bridge42worlds/wheel2/docs/spec.md

# Спецификация и смета

Из чего собрана установка и сколько это стоит. Цены — в кувейтских динарах (KWD; 1 KWD ≈ 3,25 $):

* **без знака** — как оплачено в заказах AliExpress, доставка в основном бесплатная;
* **≈** — оценка по поиску AliExpress (26.10.2026): этого нет в заказах — надо купить или куплено отдельно;
* **—** — куплено на месте или своё, без цены.

Ссылки ведут на страницы товаров; цены и варианты на них меняются. Где что стоит в установке — [схемы подключения](wiring.md).

## Итог

| раздел | куплено, KWD | оценка, KWD | всего, KWD |
|---|---|---|---|
| Агенты и датчики | 96,88 | — | 96,88 |
| Колёса и катушки | 29,64 | ≈ 32,01 | 61,65 |
| Питание колёс | 29,62 | ≈ 32,26 | 61,88 |
| Рама и моторы | 34,08 | ≈ 3,09 | 37,17 |
| Сеть опыта (Wi-Fi) | 13,81 | — | 13,81 |
| Монтаж и тепло | 4,95 | — | 4,95 |
| Инструменты и расходники | 32,92 | — | 32,92 |
| **установка без инструментов** | **208,98** | **≈ 67,36** | **276,34** (≈ 898 $) |
| **всё вместе с инструментами** | **241,90** | **≈ 67,36** | **309,26** (≈ 1 005 $) |

Ноутбук (сервер) и телефон Samsung Galaxy A26 (статический датчик №9) — свои, в смету не входят.

Купить осталось: аккумуляторы 18650 и боксы к ним, недостающие радиаторы, DRV8833 — запасные мосты катушек. Медный провод и часть радиаторов куплены отдельно, их цена неизвестна — в оценке ориентир AliExpress.

## Агенты и датчики

Платы-агенты и датчики: генераторы и поглотители на колёсах, агенты катушек и моторов, статика.

| позиция | вариант, сколько | цена | шт. | сумма | ссылка | примечание |
|---|---|---|---|---|---|---|
| Seeed XIAO ESP32-S3 — агент | упаковка 10 шт. | 22,19 и 23,58 | 2 | 45,77 | [AliExpress](https://www.aliexpress.com/item/1005006987905528.html) | 20 плат: 12 на колёсах, катушка, моторы, статика, запас |
| Акселерометр-гироскоп ICM-42688 (фиолетовая плата) | датчик обода, статика | 5,69 | 2 | 11,38 | [AliExpress](https://www.aliexpress.com/item/1005011642881650.html) |  |
| Магнитометр MLX90393 | упаковка 2 шт. | 4,98 | 1 | 4,98 | [AliExpress](https://www.aliexpress.com/item/1005012414990689.html) | поле в трубе колеса |
| Точный акселерометр ADXL355 | статика по центру оси | 23,82 | 1 | 23,82 | [AliExpress](https://www.aliexpress.com/item/1005009311859684.html) | шум 25 мкg/√Гц |
| Измеритель тока INA219 | упаковка 5 шт. | 1,79 | 1 | 1,79 | [AliExpress](https://www.aliexpress.com/item/1005004939456588.html) | заряд аккумуляторов: по одному на шину и катушку колеса |
| Seeed XIAO ESP32-C3 | упаковка 10 шт. | 4,57 | 2 | 9,14 | [AliExpress](https://www.aliexpress.com/item/1005008791937363.html) | в установке не используются — запас |

Раздел: куплено **96,88 KWD**.

## Колёса и катушки

Обод — силиконовая труба на алюминиевом диске, на трубу намотана катушка; мост катушки, радиаторы агентов.

| позиция | вариант, сколько | цена | шт. | сумма | ссылка | примечание |
|---|---|---|---|---|---|---|
| Алюминиевый диск 6061 Ø300 × 3 мм | основа колеса | 10,38 | 2 | 20,76 | [AliExpress](https://www.aliexpress.com/item/1005008038945720.html) |  |
| Силиконовая трубка пищевая, ID 19 × OD 23 мм | обод — агенты внутри | 6,56 | 1 | 6,56 | [AliExpress](https://www.aliexpress.com/item/1005010025288570.html) |  |
| Клипсы ПВХ U-образные 25 мм | 20 шт. | 2,32 | 1 | 2,32 | [AliExpress](https://www.aliexpress.com/item/1005009762220367.html) | крепят трубу к диску |
| Эмалированный медный провод 0,67 мм | ~200 м на два колеса (≈0,6 кг) | ≈ 19,18 | 1 | ≈ 19,18 | [AliExpress](https://www.aliexpress.com/item/1005003650119052.html) | куплен отдельно; ориентир — катушка 1 кг |
| Мост DRV8833 — запасной для катушек | 2,7–10,8 В | ≈ 0,76 | 2 | ≈ 1,52 | [AliExpress](https://www.aliexpress.com/item/1005009044264044.html) | на катушках работают DRV8871 от 5,1 В (вне паспорта); эти — на случай отказа |
| Радиатор алюминиевый 10 × 10 × 10 мм | по 2 на агента: 24 шт. (3 упаковки по 10) | ≈ 3,77 | 3 | ≈ 11,31 | [AliExpress](https://www.aliexpress.com/item/1005004079109702.html) | часть уже стоит на агентах — уточнить, сколько есть |

Раздел: куплено **29,64 KWD**, докупить или оценка **≈ 32,01 KWD**.

## Питание колёс

По два блока 2×18650 на колесо (шина агентов и катушка), DC-DC 5,1 В, защита и проводка.

| позиция | вариант, сколько | цена | шт. | сумма | ссылка | примечание |
|---|---|---|---|---|---|---|
| Аккумулятор 18650, 3400 мА·ч (LiitoKala NCR18650B) | 8 в работе + 2 запасных | ≈ 2,71 | 10 | ≈ 27,10 | [AliExpress](https://www.aliexpress.com/item/1005010576713983.html) | купить; нынешние банки слабые — около 0,7 А·ч на пару ([замер](coil_test.md)); литиевые аккумуляторы в Кувейт везут не все продавцы — проверить доставку |
| Бокс 2×18650 с крышкой и выключателем | по 2 на колесо | ≈ 1,29 | 4 | ≈ 5,16 | [AliExpress](https://www.aliexpress.com/item/4001207701699.html) | купить |
| Зарядное устройство LiitoKala Lii-402 | на 4 аккумулятора | 3,96 | 1 | 3,96 | [AliExpress](https://www.aliexpress.com/item/1005008078706966.html) |  |
| DC-DC LM2596 с вольтметром | 3 шт. | 1,40 | 3 | 4,20 | [AliExpress](https://www.aliexpress.com/item/1005010587294093.html) | 5 в работе: шина и катушка каждого колеса, агент моторов |
| DC-DC LM2596 с индикатором | 2 шт. | 1,24 | 2 | 2,48 | [AliExpress](https://www.aliexpress.com/item/1005006735114768.html) |  |
| Диоды Шоттки 1N5819 | 50 шт. | 0,86 | 1 | 0,86 | [AliExpress](https://www.aliexpress.com/item/1005001552094086.html) | полоской к 5V агента |
| Диоды 1N4007 | 50 шт. | 0,76 | 1 | 0,76 | [AliExpress](https://www.aliexpress.com/item/1005001552094086.html) | запас |
| Электролиты 470 мкФ 25 В | 20 шт. | 0,85 | 1 | 0,85 | [AliExpress](https://www.aliexpress.com/item/1005005945721276.html) | C1–C3 на шине, у мостов |
| Электролиты, набор | 120 шт. | 1,02 | 1 | 1,02 | [AliExpress](https://www.aliexpress.com/item/1005006244064108.html) |  |
| Керамика 104 (0,1 мкФ) 50 В | 100 шт. | 0,68 | 1 | 0,68 | [AliExpress](https://www.aliexpress.com/item/1005008165798085.html) | на выводах моторов |
| Керамика, набор | 300 шт. | 1,15 | 1 | 1,15 | [AliExpress](https://www.aliexpress.com/item/1005008244407175.html) |  |
| Держатель предохранителя 18AWG с предохранителем 3 А | 2 шт. | 0,73 | 2 | 1,46 | [AliExpress](https://www.aliexpress.com/item/1005007369776673.html) |  |
| Провод 2 × 18 AWG (красный-чёрный) | 10 м | 3,22 | 1 | 3,22 | [AliExpress](https://www.aliexpress.com/item/1005009014635843.html) | шины |
| Провод силиконовый 20 AWG | 3 м | 0,70 | 1 | 0,70 | [AliExpress](https://www.aliexpress.com/item/1005009017260144.html) |  |
| Провод силиконовый 22 AWG | 3 м | 0,64 | 1 | 0,64 | [AliExpress](https://www.aliexpress.com/item/1005009017260144.html) |  |
| Т-соединители проводов | 20 шт. | 2,24 | 1 | 2,24 | [AliExpress](https://www.aliexpress.com/item/1005011893119817.html) | отводы от шины к агентам |
| Разъёмы H2, 2 контакта | 50 шт. | 1,53 | 1 | 1,53 | [AliExpress](https://www.aliexpress.com/item/1005008802959407.html) |  |
| Клеммники компактные | 5 шт. | 0,57 | 4 | 2,28 | [AliExpress](https://www.aliexpress.com/item/1005012488325489.html) |  |
| Термоусадка, набор | 127 шт. | 0,89 | 1 | 0,89 | [AliExpress](https://www.aliexpress.com/item/1005010440409440.html) |  |
| Вольтметр-амперметр DC 100 В 10 А | 1 шт. | 0,70 | 1 | 0,70 | [AliExpress](https://www.aliexpress.com/item/1005005631605113.html) |  |

Раздел: куплено **29,62 KWD**, докупить или оценка **≈ 32,26 KWD**.

## Рама и моторы

Моторы на осях колёс, мосты, агент моторов на раме; блок 12 В.

| позиция | вариант, сколько | цена | шт. | сумма | ссылка | примечание |
|---|---|---|---|---|---|---|
| Мотор-редуктор 36GP-555, 12 В, 112 об/мин | по одному на колесо | 14,23 | 2 | 28,46 | [AliExpress](https://www.aliexpress.com/item/1005012582421407.html) |  |
| Мост DRV8871 | упаковка 5 шт. | 3,86 | 1 | 3,86 | [AliExpress](https://www.aliexpress.com/item/1005012157077217.html) | моторы — 2, катушка колеса 1 — 1 (от 5,1 В работает) |
| Опора вала с фланцем, 8 мм | 2 шт. | 0,88 | 2 | 1,76 | [AliExpress](https://www.aliexpress.com/item/1005011593372874.html) |  |
| Блок питания 12 В 5 А (60 Вт) | моторы и агент моторов | ≈ 3,09 | 1 | ≈ 3,09 | [AliExpress](https://www.aliexpress.com/item/1005004110696893.html) | в заказах AliExpress нет — уточнить, какой стоит |
| Фанера 12 мм, подшипники упоров, муфты, крепёж | рама и упоры | — | 1 | — | — | куплено на месте |

Раздел: куплено **34,08 KWD**, докупить или оценка **≈ 3,09 KWD**.

## Сеть опыта (Wi-Fi)

Свой роутер только для агентов; ноутбук — к нему кабелем, интернет — по своему Wi-Fi.

| позиция | вариант, сколько | цена | шт. | сумма | ссылка | примечание |
|---|---|---|---|---|---|---|
| Роутер GL.iNet GL-MT300N-V2 (Mango) | 2,4 ГГц, питание micro-USB 5 В | 8,60 | 1 | 8,60 | [AliExpress](https://www.aliexpress.com/item/1005005454366776.html) | настройки — [схемы, «Сеть опыта»](wiring.md#сеть-опыта-wi-fi) |
| Адаптер UGREEN USB 3.0 → RJ45 (ASIX AX88179) | ноутбук ↔ LAN роутера | 3,30 | 1 | 3,30 | [AliExpress](https://www.aliexpress.com/item/1005007088906526.html) |  |
| Кабель Cat6 | 3 м | 1,91 | 1 | 1,91 | [AliExpress](https://www.aliexpress.com/item/1005009029087811.html) |  |
| Второй роутер (домашний) | запасная сеть агентов | — | 1 | — | — | свой |

Раздел: куплено **13,81 KWD**.

## Монтаж и тепло

Крепление радиаторов и плат, изоляция под обмоткой.

| позиция | вариант, сколько | цена | шт. | сумма | ссылка | примечание |
|---|---|---|---|---|---|---|
| Двусторонний термоскотч 10 мм | 5 м | 0,92 | 1 | 0,92 | [AliExpress](https://www.aliexpress.com/item/1005005721222386.html) | радиаторы на плату |
| Каптоновая лента 20 мм | 33 м | 1,65 | 1 | 1,65 | [AliExpress](https://www.aliexpress.com/item/1005002708125522.html) | кромки радиаторов под проводом |
| Клей AB для металла | 50 мл | 2,00 | 1 | 2,00 | [AliExpress](https://www.aliexpress.com/item/1005008690859660.html) |  |
| Нано-лента двусторонняя 20 мм | 1 м | 0,38 | 1 | 0,38 | [AliExpress](https://www.aliexpress.com/item/1005010778627319.html) |  |

Раздел: куплено **4,95 KWD**.

## Инструменты и расходники

Для сборки — в стоимость самой установки не входят.

| позиция | вариант, сколько | цена | шт. | сумма | ссылка | примечание |
|---|---|---|---|---|---|---|
| Паяльник 60 Вт с регулятором (S806), набор 7 в 1 |  | 2,49 | 1 | 2,49 | [AliExpress](https://www.aliexpress.com/item/1005007111909400.html) |  |
| «Третья рука» с лупой, 4 держателя |  | 2,17 | 1 | 2,17 | [AliExpress](https://www.aliexpress.com/item/1005009212103647.html) |  |
| Силиконовый коврик для пайки |  | 1,27 | 1 | 1,27 | [AliExpress](https://www.aliexpress.com/item/1005005241808257.html) |  |
| Лупа-очки |  | 6,00 | 1 | 6,00 | [AliExpress](https://www.aliexpress.com/item/1005005669666176.html) |  |
| Отвёртка 7 в 1 |  | 1,21 | 1 | 1,21 | [AliExpress](https://www.aliexpress.com/item/1005012615752371.html) |  |
| Стриппер-обжимник 10–26 AWG |  | 2,61 | 1 | 2,61 | [AliExpress](https://www.aliexpress.com/item/1005009138448458.html) |  |
| Набор ножей |  | 0,70 | 1 | 0,70 | [AliExpress](https://www.aliexpress.com/item/1005005733410013.html) |  |
| Струбцины 4" | 5 шт. | 5,10 | 1 | 5,10 | [AliExpress](https://www.aliexpress.com/item/1005007147995927.html) |  |
| Пружинные зажимы 3" | 6 шт. | 1,66 | 2 | 3,32 | [AliExpress](https://www.aliexpress.com/item/1005006441096614.html) |  |
| Струбцины 2" | 10 шт. | 1,46 | 1 | 1,46 | [AliExpress](https://www.aliexpress.com/item/1005008565541292.html) |  |
| Припой ПОС-63 с канифолью, 0,8 мм | 50 г | 1,37 | 1 | 1,37 | [AliExpress](https://www.aliexpress.com/item/1005009113499721.html) |  |
| Флюс-карандаш 951 |  | 1,53 | 1 | 1,53 | [AliExpress](https://www.aliexpress.com/item/1005009476418222.html) |  |
| Оплётка для снятия припоя 2,5 мм | 1,5 м | 0,68 | 1 | 0,68 | [AliExpress](https://www.aliexpress.com/item/1005012817073895.html) |  |
| Паяльная паста | 15 г | 1,03 | 1 | 1,03 | [AliExpress](https://www.aliexpress.com/item/1005009377104599.html) |  |
| Ёмкость из нержавейки | 300 мл | 1,34 | 1 | 1,34 | [AliExpress](https://www.aliexpress.com/item/1005010588950996.html) |  |
| Подставка Type-C |  | 0,64 | 1 | 0,64 | [AliExpress](https://www.aliexpress.com/item/1005012357688054.html) |  |

Раздел: куплено **32,92 KWD**.
