bridge42worlds/wheel2/docs/check_2026-11-03.md

# Первая полная проверка установки

Журнал 03.11.2026, вечер. Всё включено: оба колеса (по шесть агентов на шине и агент катушки), статический
акселерометр №8, колесо‑пустышка №22 и №23, телефон №9, агент моторов №10. Колёса крутили только медленно
(ШИМ 30 %, ~25 об/мин), до невесомости (73 об/мин) не разгоняли — механику ещё смотрят.

## Прошивка

Все 19 плат прошиты по Wi‑Fi сборкой **6da4bb9** (коммит того же дня), каждая подтвердила новую версию.

| кто | было | прошивка по Wi‑Fi |
|---|---|---|
| колесо 1: №3, №5, №6, №11, №12, №20, катушка №13 | fcee625 | 7 плат за 83 с |
| колесо 2: №14–№19, катушка №21 | 4b221d0, 46f9960 | 7 плат за 79 с |
| статика №8, пустышки №22, №23 | fcee625, be44124-dirty | 3 платы за 75 с |
| моторы №10 | fcee625 | 75 с |

Новое в 6da4bb9: своё рассеяние `ss` ([scatter.md](scatter.md)), переменное поле катушек и поле «с вращением»
([sensors.md](sensors.md)), метка верха колеса.

## Агенты и датчики

| что | итог |
|---|---|
| связь | ✓ все на связи; за 20 с потерь 0 (у №16 — один пакет из 20); прежние 6–9 % потерь — от общего включения |
| акселерометр обода №6 (колесо 1) | ✓ 200 Гц, ошибок 0, \|a\| 995–1001 мg, гироскоп стоит; шум 0,45–0,59 мg, во второй раз 2,4–4,3 мg — колесо трогали |
| акселерометр обода №14 (колесо 2) | ✓ 200 Гц, ошибок 0, \|a\| 994–996 мg, шум 0,55–1,2 мg |
| магнитометр №20 (колесо 1) | ✓ шум до 1,7 мкТл; фон 84, потом 67 мкТл (обычно 25–65) — железо рядом, не датчик |
| магнитометр №18 (колесо 2) | ✓ фон 25–31 мкТл, шум до 1,7 мкТл |
| статика №8 (ADXL355) | ✓ 504 Гц, без пропусков, шум 0,4–1,2 мg |
| телефон №9 | ✓ акселерометр 481 Гц без пропусков (шум 0,7–1,8 мg), магнитометр ~120 Гц, батарея 50 % |
| аккумуляторы катушек | ✓ колесо 1 — 8,11 В (85 %), колесо 2 — 7,94 В (76 %); агент катушки без поля берёт 90–94 мА |

## Катушки

**Постоянное поле** (выкл → «+» → выкл → «−», 4 раза): ✓ на обоих колёсах ток шёл 4 из 4, поле по магнитометру
колеса 1305–1328 мкТл (колесо 1) и 1327–1342 мкТл (колесо 2), знак совпал с командой, после выключения — фон.

**Переменное поле** (обе катушки по очереди):

| род | итог |
|---|---|
| ∿ 1 Гц | ✓ огибающая растёт за ~3 с; фаза агента к часам сервера сходится до ±2 тысячных периода; магнитометр видит размах \|B\| 1285–1355 мкТл |
| ∿ 5 Гц | ✓ частота меняется на ходу; фаза ±2–26 тысячных (до 9°) — задержка сети при 5 Гц уже заметна |
| ⊓ мягкий меандр 1 Гц | ✓ смена формы через ноль; ток до 0,89–0,98 А |
| выкл | ✓ ток катушки спадает до тока агента (~92 мА) |

## Счёт и своё рассеяние

* **«Каждый сам», 30 с, все 14 генераторов** (оба колеса и пустышки): ✓ 23–25 простых в секунду на плату, ошибок 0,
  настройку приняли все; нагрев за 30 с — 41–46 °C, пустышки без радиаторов — 58–61 °C.
* **Своё рассеяние `ss`** (№3 сам рассеивает, №5 рядом без него, 40 с): ✓ 989 простых → 990 кадров, пропусков 0,
  шум не ждали, задержка 0,61 мс; №5 услышал 98 % кадров; скорость №3 не упала (~25 простых/с, как у №5).

## Моторы и вращение

* ШИМ 30 %, каждое колесо туда‑обратно по 6 с: колесо 1 — 22–25 об/мин, колесо 2 — 25–27 об/мин; \|a\| обода
  0,87–1,12 g — как должно при таких оборотах (k ≈ 0,1).
* Метка верха: ✓ у №6 приходит, период 2601 мс = 23,1 об/мин.
* **Найдено и исправлено:** перестановка мостов (`swap`, «колесо 1 на мосту b», поставлена 30.10) стала неверной —
  «колесо 1» крутило колесо, на котором №14 и №18. В режимах «по оборотам» и «невесомость» сервер разгонял бы одно
  колесо, а смотрел бы обороты другого (стоящего) и поднимал бы ШИМ до ограничителя. Перестановка снята; проверено:
  мост a → колесо 1 (№6 до 24,9 об/мин), мост b → колесо 2 (№14 до 26,1 об/мин), другое колесо стоит.
* Колесо 2 в первом заходе вперёд почти не пошло (1,6 об/мин в последнюю секунду). Повторная проверка — 6 стартов
  из 6 чистые: трогается через 1,4–1,6 с вперёд и 1,8–2,0 с назад (с разгоном мотора), идёт 25–27 об/мин. Назад
  трогается на 0,3–0,4 с позже — проверить люфт.

## Заминки

* Колесо‑пустышка сразу после прошивки не получило две команды подряд (в счётчике агента их нет, отказа нет);
  третья дошла, дальше всё работало. Вне программы сервер потерянную настройку не повторяет — она висит
  «в ожидании».

## Не проверено

* Обе катушки вместе — в одной фазе и в противофазе (колесо 1 к тому времени выключили).
* Поле «⟳ с вращением» на катушке — нужен разгон колеса, это следующий шаг.
* Своё рассеяние в группе (каскад, эстафета), статический датчик‑участник (ещё не сделан).

## Вечер: невесомость и первые опыты

**Невесомость** (каждое колесо по очереди, мягкий разгон 150 ‰/с): колесо 1 — 71–75 об/мин, k 0,99–1,03, |f| в верхней
точке 0,01–0,06 g, ШИМ 72–74 %; колесо 2 — 70–75 об/мин, k 0,96–1,01, |f| 0,02–0,09 g, ШИМ 69–73 %. На ходу:
поле «+» по магнитометру колеса 1342–1417 мкТл; «⟳ с вращением ×1» — частота по метке верха 1,18–1,24 Гц, ошибка
фазы до 5° (колесо 1) и до 12° (колесо 2), размах поля 1195–1391 мкТл. Запас по ШИМ до предела 75–80 % небольшой.

**Найдено и исправлено в программе:**

* **Итоги после молчания.** Сервер считал агента «вернувшимся» по любому пакету; агент с ГСЧ после молчания сперва
  выгружает журнал простых (сотни prm), и итоги снимались со старой телеметрии — счёт шага выходил ~0, а следующий шаг
  применялся тут же. Теперь ждётся именно телеметрия со счётчиками (`tel_t`). Ошибка могла портить и прежние
  программы с молчанием.
* **Темп по часам агента.** Сервер делил счёт на своё окно (15,0 с), а счётчики агентов охватывали ~16,0 с, и снимок
  в начале у каждого — своей давности: на коротком опыте ±10 % случайно. Теперь темп — по `age` агента.
* **Статика не портит опыт** при `static_spoil: false` (ищем отклонения генерации, а рядом ходят).
* **Колёса друг напротив друга.** Моторы зеркальные: «навстречу» по моторам для наблюдателя — в одну сторону.
  Настройка установки `mirror` (включена): «навстречу» и «вместе» — глазами наблюдателя. Проверено на 30 %: колёса
  идут в разные стороны, ~28 об/мин каждое.

**Пять опытов по 15 с** (генерация двумя группами и К2 → К1 поглощение; навстречу на невесомости, поле + −): после
пересчёта по часам агентов — колёса +3,7 % (разброс по агентам ±3,9 %), колесо‑пустышка −9 % в опыте с вращением и
полем против контроля; поглощение: генерация К2 −3…−4 %. Контроль один — без вывода.

**13 опытов по 30 с** (петля через эфир: К2 считает только из кадров поглотителей К1; 4 контроля; поле + −, − +,
∿ 1 и 5 Гц, ⟳ ×1; «навстречу», обратно, «вместе»): аномалий нет (ближайшее p с поправкой 0,027 при пороге 0,00006).
В петле всего ~2 простых в секунду на оба колеса — по агентам счёт ~10 за опыт, разброс большой. Заметнее всего —
кандидатов в секунду −24…−30 % на вращении (опыты 3 и 6): петля держится на кадрах между колёсами, а при вращении
меняется положение антенн. Внимание: «навстречу» в этих опытах для наблюдателя было вращением в одну сторону (до
настройки `mirror`), настоящее встречное — опыт «вместе».

**Статика в 13 опытах:** аномалий нет. Во всех опытах и контролях — «⚠ проверить» от устаревшего эталона (полосы
64–256 Гц на 11–13 дБ тише, пропала линия эталона 22,6 Гц) — эталон перезаписан. В опыте «навстречу обратно» —
толчок, его одновременно видели №8 и телефон (эксцесс t ≈ +100): механика, похоже, люфт при вращении назад.

**Что дальше:** петлю — с шумом «↺+» (ГСЧ + обратный) и кандидатами как основным показателем; контролей 5–6;
проверить механику на вращении назад; опыты с настоящим встречным вращением.

## 24 опыта по 20 с (три семьи, статика ищет)

Свежий эталон статики (2 мин, всё стоит): №8 — 23 / 22 мкg/√Гц (паспорт ADXL355 — 25), телефон — 59 / 51 (паспорт 70),
шум гауссов, фон ровный. Семьи: C — стоят, генерация двумя группами; A — навстречу (уже глазами наблюдателя) на
невесомости, петля; B — то же обратно. **Генерация в A и B не шла** — петле «↺+» не дали фона поглотителей, а каждый
блок шума ждёт и обратного шума; статика от этого не зависит.

* Стоя статика чистая: «✓» во всех опытах, кроме толчков (ходили рядом); ∿ 17 Гц — шум №8 «не гауссов» (эксцесс
  0,7–0,8), опыт один.
* На вращении — линия 81,7–85,6 Гц у №8 во всех опытах и контролях: вал мотора, ≈ 68,8 × обороты колеса. Добавлена
  в известные линии (обороты — с обода, а когда он молчит, — от моторов).
* Импульсные выбросы у №8 («импульсная помеха»): в семье A — только при ∿ 5 Гц и ⊓ 1 Гц (эксцесс t +131 и +70, p с
  поправкой 0,003 и 0,01), но в семье B — и в контролях без поля, вместе с толчками. Вероятнее механика или искрение
  щёток мотора, а не поле; проверить чередованием «выкл / ∿ 5 Гц».
* «Гаусс сжался» в последнем опыте — выбросы (эксцесс 19 у №8, 9 у телефона одновременно) растягивают СКО и шкалу,
  ядро на экране выглядит узким; поле было выкл — механика.
* Телефон — только толчки.

## Итоги дня

1. Установка работает целиком: 19 плат на одной прошивке, невесомость держится (k ≈ 1, |f| наверху ≤ 0,09 g), поле
   постоянное и переменное, «⟳ с вращением», своё рассеяние, программа.
2. Аномалий не найдено. Всё заметное объясняется будничным: радио между вращающимися колёсами (петля), механика и
   мотор (статика: линия вала, толчки, выбросы на вращении назад), нагрев пустышек без радиаторов.
3. Исправлено за день: неверная перестановка мостов моторов; «навстречу» глазами наблюдателя (`mirror`); итоги после
   молчания; темп по часам агента; `static_spoil`; линия вала мотора в известных; настройка `mirror` сохраняется.
4. Механика: стук и выбросы на вращении назад, колесо 2 трогается назад позже; запас ШИМ на невесомости небольшой.

## План на завтра — серия поиска, 50 опытов (`tools/series_search.py`, ≈ 43 мин)

| семья | вращение | что считают | контроли | опыты |
|---|---|---|---|---|
| F4 | стоят | никто (только статика) | 4 | + −, + +, ∿ 1, ∿ 5, ∿ 17 Гц, ⊓ 1 Гц |
| F1 | стоят | генерация двумя группами | 4 | + −, + +, − −, ∿ 0,5 / 2 / 7 Гц, ⊓ 1 Гц, = 70 % ШИМ |
| F6 | стоят | ◈ своё рассеяние против пустышки | — | 2, разведка |
| F2 | навстречу k = 1 | К2 → К1 поглощение | 4 | + −, − +, + +, − −, ∿ 1, ⟳ ×1, ⟳ ×2, ∿ 5 Гц |
| F3 | навстречу k = 1 | петля ↺+, фон 50/с | 4 | + −, ⟳ ×1, ∿ 1 Гц + +, − − |
| F5 | 30 об/мин, k = 1 ∓ 3 % | генерация двумя группами | — | поле выкл / + −, разведка |

Разбор — `python tools/series_report.py <номер программы>`. Ещё не пробовали: поглощение К1 → К2, пустышку поглощения
как контроль, эстафету и «одно число на всех», оба колеса одной группой, пустышку участником (мост, подслушивание),
сырой шум и медленные источники под полем, силу тока катушки по ступеням, статический датчик‑участник (нужна прошивка).

В конце всё остановлено: моторы стоят, катушки выкл, агенты в «Стоп».
