bridge42worlds/wheel2/firmware/prime_lab/config.h

// Настройки генератора: приходят с сервера командой CFG, агент их применяет
// и подтверждает номером cid в каждом пакете телеметрии.
#pragma once
#include <Arduino.h>

// Источники случайности (битовая маска). Замеры 03.10.2026 — tools/probe_report.py.
// Две группы — для наших целей это разные вещи:
//   внутренние — шум рождается в самом кристалле, от окружения почти не зависит;
//   внешние    — шум приходит снаружи платы: радиоканал, наводки на ножку.
enum : uint8_t {
  // --- внутренние ---
  SRC_RNG  = 1,   // esp_random(): аппаратный генератор чипа; при включённом Wi-Fi в него
                  // подмешивается и шум приёмника; ~44 800 слов/с, 32 бита на слово
  SRC_JIT  = 8,   // дрожание RC-генератора 136 кГц относительно кварца;
                  // ~16 000 отсчётов/с, засчитываем 1/4 бита на отсчёт
  // --- внешние ---
  SRC_CSI  = 2,   // CSI Wi-Fi: замеры радиоканала по ответам роутера на пинг 100 Гц;
                  // ~97 пакетов/с, засчитываем 32 бита на пакет (оценка ~150)
  SRC_ADC  = 4,   // шум АЦП на ножке D0 (GPIO1) с подтяжками к середине питания:
                  // наводки и шум резисторов; ~21 000 отсчётов/с, 1/4 бита на отсчёт
  // --- петля ---
  SRC_BC   = 16,  // эфир сета B: содержимое услышанных кадров рассеяния (и фона) сета B;
                  // засчитываем 4 бита на байт
  // --- датчики на ободе (если запаяны; rim_sensors) ---
  SRC_ACC  = 32,  // ICM-42688: младшие байты осей ускорения и гироскопа, 200 отсчётов/с; 1 бит на байт
  SRC_MAG  = 64,  // MLX90393: младшие байты осей поля, 20 замеров/с; 2 бита на байт
  // Вместе с другими источниками датчик подмешивает в блок то, что накопил (не ждёт — счёт не
  // медленнее); один (или только датчики) — блок ждёт 256 зачтённых бит; датчика нет — вместо него ГСЧ.
  SRC_SENSORS = SRC_ACC | SRC_MAG,
  SRC_INTERNAL = SRC_RNG | SRC_JIT,
  SRC_EXTERNAL = SRC_CSI | SRC_ADC,
  SRC_MASK = 127,
};

const int MAX_BASES = 12;
const uint8_t BASES[MAX_BASES] = {2, 3, 5, 7, 11, 13, 17, 19, 23, 29, 31, 37};
const int MAX_GROUP = 16;                // агентов в группе A и в сете B — каждого

enum : uint8_t { MODE_SOLO = 0, MODE_GROUP = 1 };
// Роль агента: A — генерирует простые (каждый сам или сообща), B — рассеивает
// простые, найденные сетом A: смешивает со своим шумом и выпускает в эфир;
// S — статический акселерометр: только меряет и шлёт оси, ничего не генерирует,
// в группах не участвует, по ESP-NOW не говорит (static_role.h). Роль S агент
// помнит в своей памяти и сразу с неё стартует; смена S ↔ A/B — перезапуск.
enum : uint8_t { ROLE_A = 0, ROLE_B = 1, ROLE_S = 2, ROLE_M = 3 };   // M — агент моторов (motor.h)
// Как сет B рассеивает: тишина — только слушает; каждый сам — каждый агент B
// всё число; россыпь — каждый свой кусок числа; эстафета — по цепочке B1 → B2 → …,
// последний выпускает; пустышка — столько же кадров из одного шума, без числа.
enum : uint8_t { SM_SILENT = 0, SM_EACH = 1, SM_PIECES = 2, SM_CHAIN = 3, SM_SHAM = 4 };
// Функция рассеяния агента B: хеш SHA-256 числа с шумом; XOR с шумом;
// умножение на случайное нечётное по модулю 2^длина; перестановка бит по шуму.
enum : uint8_t { SF_HASH = 0, SF_XOR = 1, SF_MUL = 2, SF_PERM = 3 };
// Телеметрия. Молчание: агент ничего не передаёт по Wi-Fi (кроме подтверждения
// команд), команды слышит. Счётчики накопительные — за время молчания ничего не
// теряется, только подробности во времени.
enum : uint8_t { TL_NORMAL = 0, TL_RARE = 1, TL_QUIET = 2 };

struct GenConfig {
  uint32_t cid  = 0;        // номер настройки от сервера; 0 — заводская при старте
  uint8_t  src  = SRC_RNG;
  uint8_t  raw  = 0;        // как брать шум: 0 — блоки SHA-256 (числа равномерны, структура шума
                            // размешана); 1 — без хеша: младшие биты сырья прямо в число; 2 — то же
                            // с выравниванием фон Неймана (снимает перекос единиц и нулей)
  uint16_t bits = 256;      // длина кандидата: 32, 64, 128, 256, 512, 1024, 2048
  uint8_t  nb   = 8;        // число баз Миллера — Рабина: первые nb из BASES
  bool     all  = false;    // true — каждого кандидата проверяют все базы (как 8 агентов
                            // сета), false — проверка обрывается на первой базе «составное»
  uint16_t td   = 1000;     // отсев делителями меньше td; 0 — без отсева
  uint8_t  tmax = 73;       // предел температуры кристалла, °C (40..75)
  uint8_t  run  = 0;        // 1 — считать, 0 — стоять; после включения агент стоит и ждёт сессию
  uint8_t  mode = MODE_SOLO;          // каждый сам за себя или сообща
  uint8_t  ng   = 0;                  // агентов в группе
  uint8_t  grp[MAX_GROUP] = {};       // их номера в порядке эстафеты
  uint8_t  gmac[MAX_GROUP][6] = {};   // их MAC в том же порядке — из реестра сервера:
  bool     has_gmac = false;          // так агент узнаёт о новых участниках без перепрошивки
  uint8_t  nrate = 1;                 // ESP-NOW: 1 — 24 Мбит/с (802.11g); 2 — 6 Мбит/с (802.11g, берёт
                                      // на ~12 дБ более слабый сигнал); 0 — 1 Мбит/с (802.11b): кадр висит
                                      // в эфире в 20 раз дольше, плата греется (замер 03.10.2026)
  uint8_t  gv   = 0;        // вариант группы: 0 — все проверяют одно число (базы поделены); 1 — эстафета:
                            // число из кусочков всех, проверяет один всеми базами, ход по кругу; 2 — каскад:
                            // числа из кусочков всех, проверяют все сразу, каждый свои
  uint8_t  rk   = 1;        // эстафета и каскад: простых за ход (1..16), потом ход следующему
  uint16_t pw   = 0;        // эстафета и каскад: ждать кусочки не дольше pw мс, потом собрать число из
                            // тех, что пришли (недостающие — своим шумом); 0 — ждать всех, переспрашивая
  uint8_t  kmax = 24;       // «все на одном числе»: кандидатов за один сбор (4..64); эстафета и каскад
                            // берут сколько влезает в кадр
  uint8_t  pre  = 1;        // группа: кусочки шума заранее (действует только при одном ГСЧ)
  uint16_t cpu  = 240;      // частота процессора, МГц: 80, 160, 240 (меняет скорость счёта)
  uint8_t  dc   = 0;        // два ядра. «Каждый сам»: ядро связи в свободное время набирает шум и отсеивает
                            // кандидатов, ядро счёта только проверяет; шум берёт одно ядро (prime_lab.ino).
                            // Эстафета: у проверяющего ядро связи складывает и отсеивает, ядро счёта проверяет
  uint8_t  role = ROLE_A;   // роль: генерация (A) или рассеяние (B)
  uint8_t  sm   = SM_EACH;  // как сет B рассеивает простые
  uint8_t  sf   = SF_HASH;  // функция рассеяния этого агента (если он в сете B)
  uint8_t  cf   = 0;        // CSI: 0 — с любых кадров, 1 — только с ответов роутера, 2 — только с кадров сета B
  uint8_t  sh   = 0;        // пустышка: сет B выпускает тот же трафик, но вместо числа — только шум
  uint8_t  bgr  = 0;        // фон сета B: кадров своего шума в секунду, независимо от простых (0 — нет)
  uint8_t  rt   = 0;        // агент обода: метку верха колеса слать и при молчании (поле катушек с вращением)
  uint8_t  ss   = 0;        // генератор сам рассеивает свои простые: каждое ss-е (1..16) смешивает со своим
                            // шумом функцией sf и выпускает в эфир с ядра связи; sh — пустышка; 0 — нет
  uint64_t ba   = 0;        // сет B: чьи простые поглощать — бит k = агент №k (0 — всех); «ba=3,5» в CFG
  uint8_t  nbg  = 0;        // агентов в сете B (сервер подставляет сам)
  uint8_t  bg[MAX_GROUP] = {};        // их номера по порядку
  uint8_t  bmac[MAX_GROUP][6] = {};   // их MAC
  bool     has_bmac = false;
  // --- меняются на ходу, счёт не обнуляют ---
  uint8_t  txp  = 20;       // мощность передатчика, дБм (2..20): Wi-Fi и ESP-NOW — одно радио
  uint8_t  ping = 100;      // пингов роутера в секунду для CSI (10..200; 0 — без пинга)
  uint8_t  hb   = 1;        // пульс: кадров «я жив» в секунду всем (1..20) — для соседей это и источник CSI без пинга
  uint8_t  led  = 1;        // вспышка светодиода раз в секунду, пока считает
  uint16_t tp   = 1000;     // период телеметрии, мс (500..5000)
  uint8_t  tl   = TL_NORMAL; // телеметрия: обычная, редкая (в 10 раз реже), молчание
  uint16_t tq   = 0;        // молчание: секунд, потом снова обычная; 0 — пока не отменят
  uint16_t rmm  = 450;      // радиус установки датчика вращения, мм — для сверки с измеренным
  uint8_t  pl   = 0;        // журнал простых: 1 — каждое найденное простое с меткой времени уходит на сервер (prime_log.h)
  uint16_t dur  = 0;        // шаг на агенте: через столько секунд счёта агент сам останавливается (run 0, счётчики
                            // замирают), возвращает радио и телеметрию и сдаёт итоги ("done" = cid в tel); 0 — пока не остановят
  uint8_t  ro   = 0;        // радио на шаге (только с dur): 1 — выключить Wi-Fi на время шага, если эфир шагу не нужен
                            // (каждый сам, без сета B, шум не из эфира) — ни одного кадра от платы, пока считает
  uint8_t  afs  = 2;        // статический: предел акселерометра, ±g (2, 4, 8, 16)
  uint8_t  avg  = 2;        // статический: среднее по стольким отсчётам 1000 Гц (1, 2, 4, 8) —
                            // на сервер идёт 1000/avg Гц
};

// Совпадают ли настройки счёта (всё, кроме номера, run и параметров «на ходу»).
bool same_work(const GenConfig& a, const GenConfig& b);
// Отличаются ли параметры, которые меняются на ходу без сброса счёта:
// предел температуры, мощность передатчика, пинг, светодиод, телеметрия, радиус,
// журнал простых, предел и усреднение статического акселерометра, длительность шага и радио на шаге.
bool soft_differs(const GenConfig& a, const GenConfig& b);
// Сохранить ли счётчики при новой настройке:
//   тот же номер (сменились параметры «на ходу») — да;
//   новый номер, но сменились только параметры «на ходу» — да;
//   остановка (run 1 → 0) с теми же настройками — да: итоги сессии замирают
//   и уходят на сервер, пока агент стоит;
//   старт (run 0 → 1) или та же настройка с новым номером — нет, счёт с нуля.
inline bool keep_stats(const GenConfig& n, const GenConfig& old) {
  if (!same_work(n, old)) return false;
  if (old.run && !n.run) return true;
  return n.run == old.run && (n.cid == old.cid || soft_differs(n, old));
}

// Разбор строки "CFG cid=12 src=3 bits=256 nb=8 all=0 td=1000 tmax=70 mode=1 gv=0 rk=1 pw=0 grp=1,2
//                gm=68ee8f51a018,68ee8f51ae20 nr=1 k=24 pre=1 cpu=240 txp=20 ping=100 led=1 tp=1000
//                role=0 sm=1 sf=0 cf=0 sh=0 bgr=0 ss=0 bg=3 bm=68ee8f51a03c ba=1,2 afs=2 avg=2 pl=0 dur=0 ro=0".
// Незаданные поля берутся из cur. При ошибке — false и причина в err.
bool parse_config(const char* line, const GenConfig& cur, GenConfig& out, char* err, size_t errlen);

// Маска шума для entropy_fill: источники и, в битах 8–9, как брать шум.
inline uint16_t noise_mask(const GenConfig& c) { return (uint16_t)(c.src | (c.raw << 8)); }
