bridge42worlds/wheel2/firmware/prime_lab/rim_sensors.h

// Датчики на ободе: ICM-42688 (обороты, невесомость) и MLX90393 (магнитное
// поле) — если подключены к I2C (D4 — SDA, D5 — SCL). Ищутся при старте;
// нет — ничего не происходит. Читает их своя задача на ядре связи с низким
// приоритетом: ядро счёта и протокол группы не задерживаются.
//
// ICM-42688: ±16 g (на 2 об/с внизу 8,25 g), ±2000 °/с (2 об/с = 720 °/с),
// 200 Гц, полоса 40 Гц. Обороты, k = ω²r/g, |f| вверху и внизу, радиус, оси
// колеса — WheelTracker (библиотека agent_sensors). MLX90393: 20 Гц,
// усиление само по величине поля.
#pragma once
#include <Arduino.h>
#include <wheel.h>
#include "jsonout.h"

namespace rim {

enum : uint8_t { HAS_IMU = 1, HAS_MAG = 2 };
static const int NS = 20;     // показаний в пакете: 20 Гц за секунду
static const int NREV = 6;    // оборотов в пакете (2 об/с — 2 за секунду)

void    begin();              // найти датчики; есть — запустить задачу
void    set_radius(float r_mm);
uint8_t present();            // HAS_IMU | HAS_MAG

// Тела пакетов (после заголовка): забирают накопленное с прошлого раза.
void add_imu(Out& o);         // сводка, обороты, показания в осях колеса
// Верх колеса: сколько мс назад агент прошёл верхнюю точку (по последнему обороту), период оборота, мс, номер
// оборота. false — колесо стоит или оборота не было дольше 2,5 периода. Для поля «с вращением» (катушки).
bool top(uint32_t& age_ms, uint32_t& period_ms, uint32_t& n);
void add_imr(Out& o);         // сырые показания акселерометра и гироскопа в осях датчика
void add_imc(Out& o);         // форма кривой за оборот: k по форме, фаза тяжести, масштаб гироскопа, среднее по осям
void add_mag(Out& o);         // поле: среднее, крайние, отдельные замеры
void add_tel(Out& o);         // поля для основного пакета: что найдено, режимы из регистров

}  // namespace rim
