bridge42worlds/wheel2/tools/prime_stats.py

"""Статистика потока простых из журнала (data/primes/<дата>/<mac>.txt).

    python tools/prime_stats.py [дата YYYY-MM-DD] [--mac 68:ee:…] [--cid N] [--recheck]

Строка журнала: время сервера, часы агента (мс), номер настройки, бит, откуда
(0 — каждый сам, 1 — сообща), число (hex), проверка сервером (1/0).

Что проверяется — то, чем поток простых обязан быть у честного генератора:
  * все числа простые (по журналу; --recheck — перепроверить здесь ещё раз);
  * нет повторов (одно простое дважды — почти невозможно для 256 бит);
  * остатки по модулю 3, 5, 7, 11 равновероятны среди допустимых (хи-квадрат);
  * биты числа (кроме старшего и младшего — они выставлены) — единицы в половине случаев;
  * второй сверху и второй снизу бит, последняя шестнадцатеричная цифра — равномерны;
  * промежутки между находками по часам агента: у пуассоновского потока разброс равен
    среднему (коэффициент вариации ≈ 1), промежутки не коррелируют между собой.
Печатает z и p; z больше ~4 — повод смотреть, что не так (или что так).
"""
import argparse, math, os, sys
from collections import Counter, defaultdict

sys.path.insert(0, os.path.join(os.path.dirname(os.path.abspath(__file__)), "..", "server"))
ROOT = os.path.join(os.path.dirname(os.path.abspath(__file__)), "..")


def chi2_p(x, df):
    """P(X > x) для хи-квадрат с df степенями свободы (приближение Уилсона — Хилферти)."""
    if df <= 0:
        return 1.0
    z = ((x / df) ** (1 / 3) - (1 - 2 / (9 * df))) / math.sqrt(2 / (9 * df))
    return 0.5 * math.erfc(z / math.sqrt(2))


def z_p(z):
    return math.erfc(abs(z) / math.sqrt(2))


def load(day, mac=None, cid=None):
    d = os.path.join(ROOT, "data", "primes", day)
    rows = []
    if not os.path.isdir(d):
        return rows
    for fn in sorted(os.listdir(d)):
        m = ":".join(fn[:-4][i:i + 2] for i in range(0, 12, 2))
        if mac and m != mac.lower():
            continue
        for ln in open(os.path.join(d, fn), encoding="utf-8"):
            f = ln.split()
            if len(f) < 7:
                continue
            if cid is not None and int(f[2]) != cid:
                continue
            rows.append({"mac": m, "rx": float(f[0]), "ms": int(f[1]), "cid": int(f[2]), "bits": int(f[3]),
                         "src": int(f[4]), "hex": f[5], "ok": f[6] == "1"})
    return rows


def global_dups():
    """Повторы по всем журналам за все дни: [(число hex, [(день, mac, настройка)…])]."""
    base = os.path.join(ROOT, "data", "primes")
    seen, dups, n = {}, {}, 0
    for day in sorted(os.listdir(base)) if os.path.isdir(base) else []:
        for r in load(day):
            n += 1
            k = r["hex"].lower()
            where = (day, r["mac"], r["cid"])
            if k in seen:
                dups.setdefault(k, [seen[k]]).append(where)
            else:
                seen[k] = where
    return n, sorted(dups.items())


_BIT_EXPECT = {}
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
