bridge42worlds/wheel2/(commit log)

2026-10-20 Wheel-2: first public version
    [devices.csv]
2026-10-25 Снимок проекта от 25.10.2026
    [devices.csv]
2026-10-26 Снимок проекта от 26.10.2026
2026-10-27 Снимок проекта от 27.10.2026
2026-11-01 Снимок проекта от 01.11.2026
    [devices.csv]
2026-11-02 Снимок проекта от 02.11.2026
2026-11-03 Снимок проекта от 03.11.2026
    [devices.csv]
